Andy4495/PiMac/jpg/Raspberry_Pi.jpg

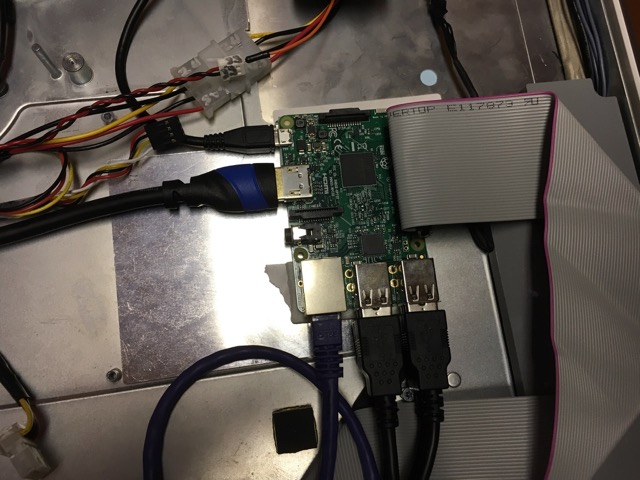
jpg/Raspberry_Pi.jpg
