Andy4495/PiMac/jpg/SMB_State_Machine.jpg

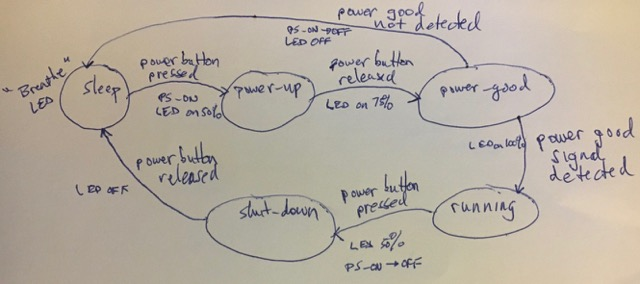
jpg/SMB_State_Machine.jpg
